Maitreya30Arnav/Mechnical_arm/Assem1.SLDASM

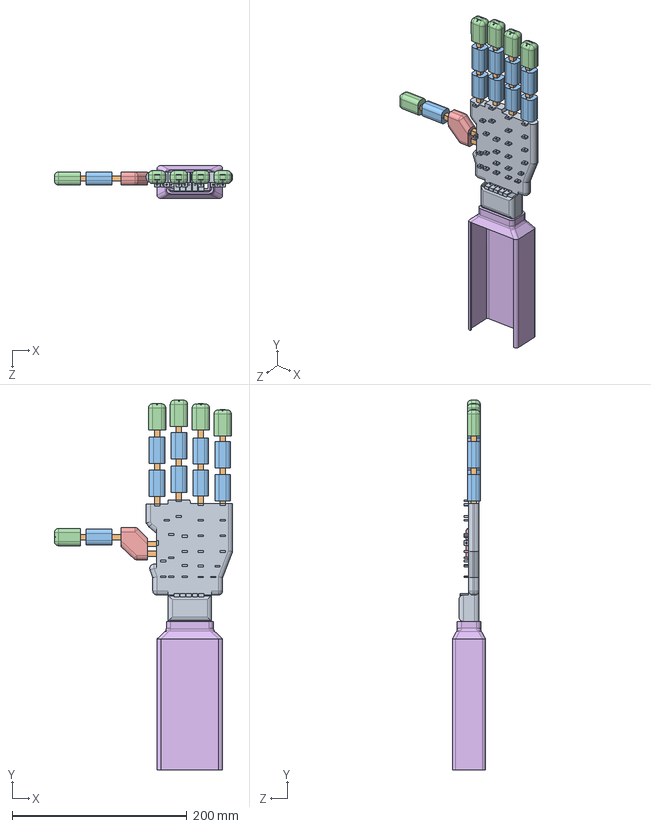
[picture p16: CAD file, 2024-07-07]
Assem1.SLDASM
204.1 x 423.2 x 38.0 mm
pp
MID FINGER PART x 9
finget tip x 5
th
hand extend
