Maitreya30Arnav/Mechnical_arm/Part3.SLDPRT

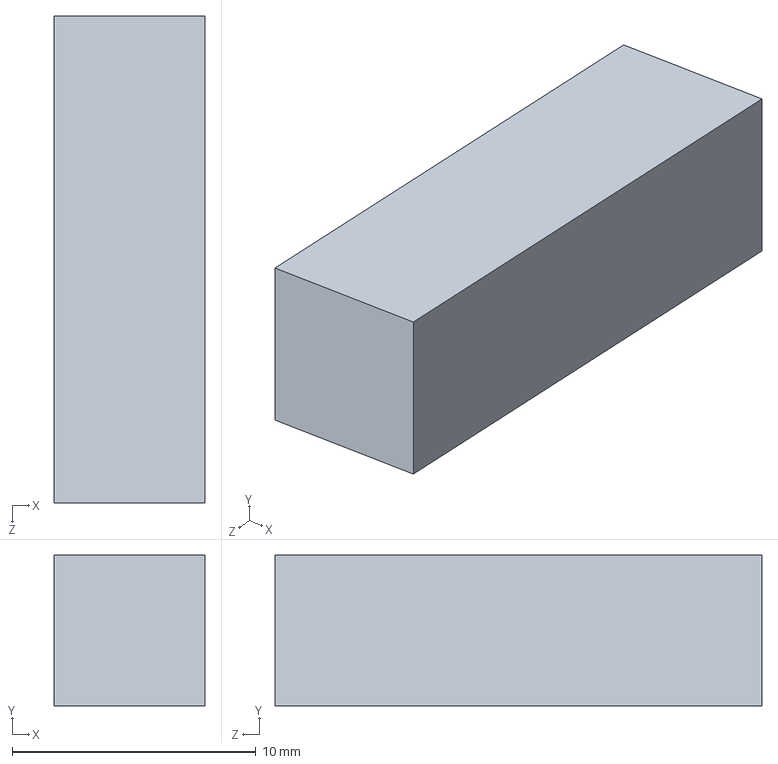
[picture p17: CAD file, 2024-07-07]
Part3.SLDPRT
6.20 x 6.20 x 20.0 mm
