Maitreya30Arnav/Mechnical_arm/finget tip.SLDPRT

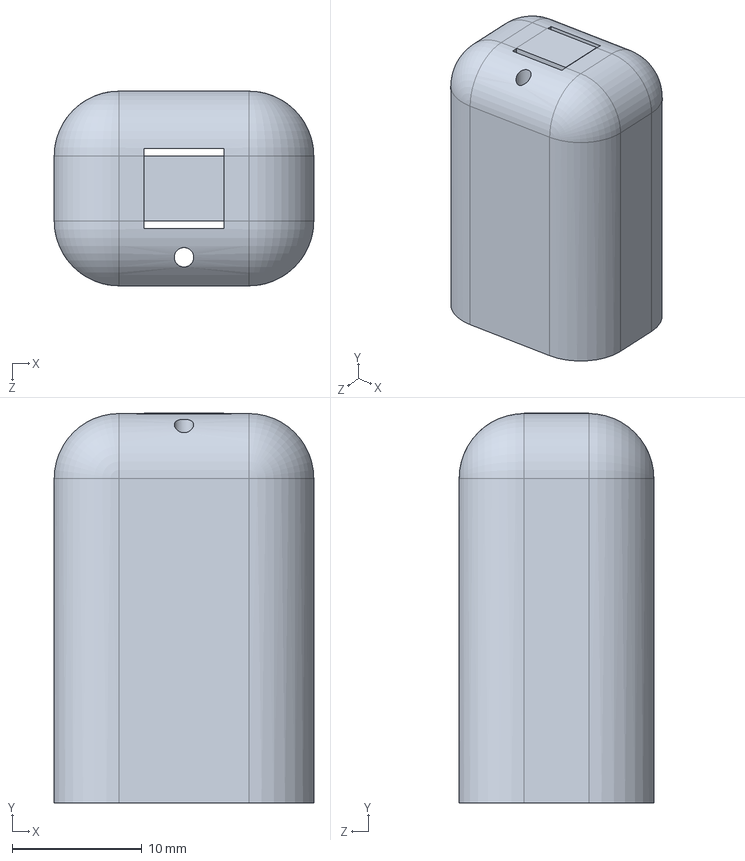
[picture p18: CAD file, 2024-07-07]
finget tip.SLDPRT
20.0 x 30.0 x 15.0 mm
