Maitreya30Arnav/Mechnical_arm/MID FINGER PART.SLDPRT

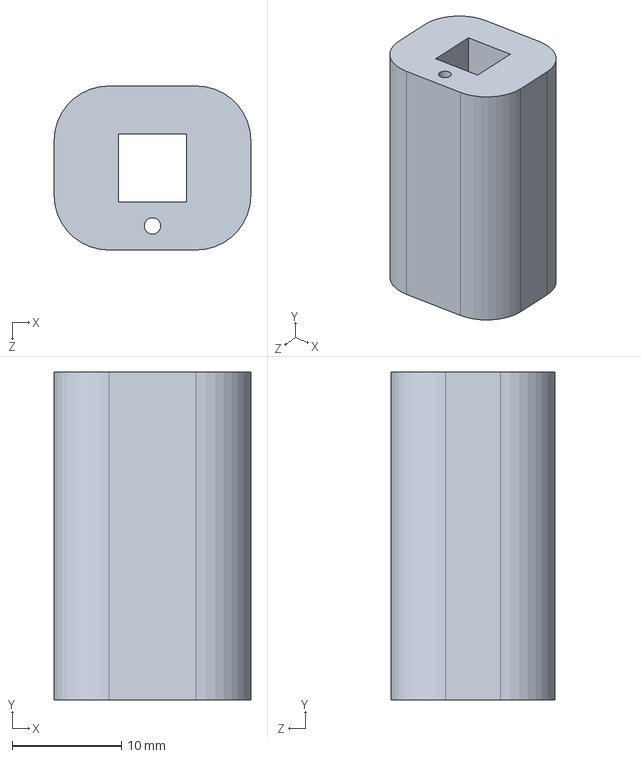
[picture p19: CAD file, 2024-07-07]
MID FINGER PART.SLDPRT
18.0 x 30.0 x 15.0 mm
