Maitreya30Arnav/Mechnical_arm/th.SLDPRT

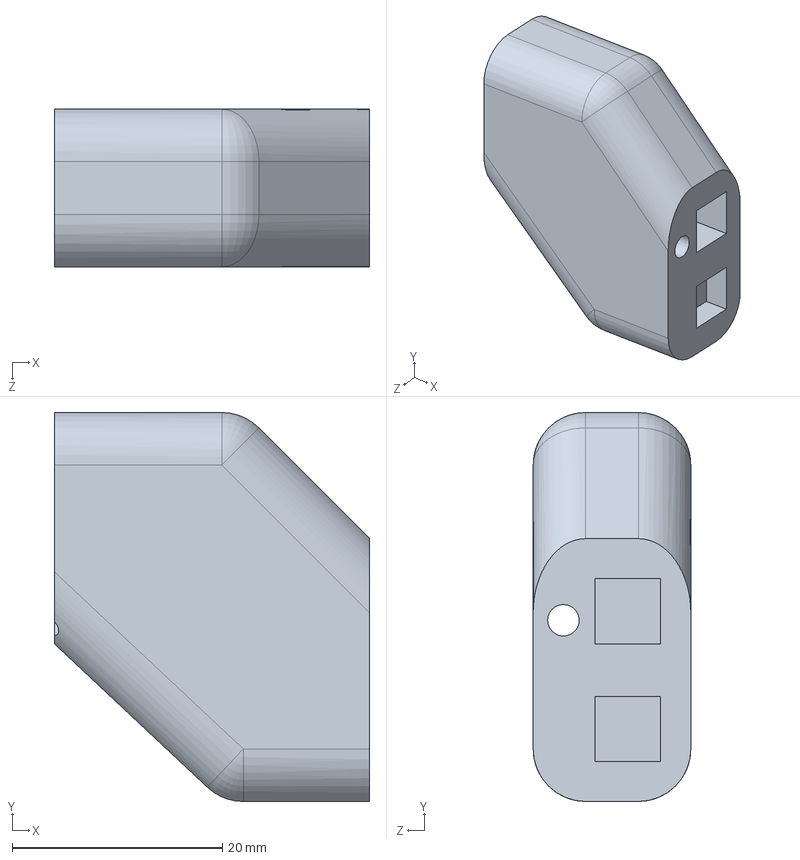
[picture p20: CAD file, 2024-07-07]
th.SLDPRT
30.0 x 37.0 x 15.0 mm
