Maitreya30Arnav/Mechnical_arm/pp.SLDPRT

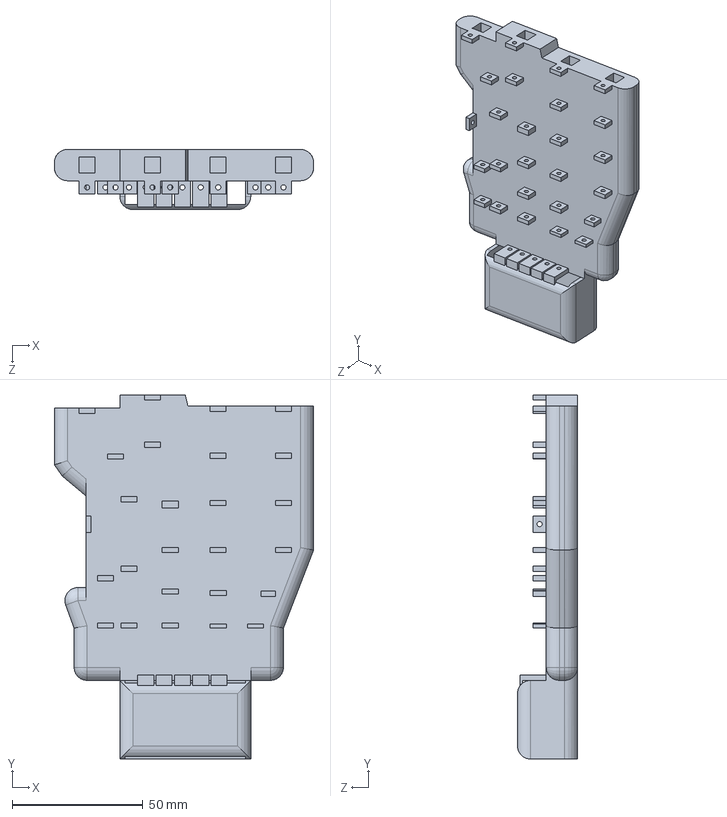
[picture p21: CAD file, 2024-07-07]
pp.SLDPRT
99.0 x 139.0 x 23.0 mm
