Maitreya30Arnav/Mechnical_arm/hand extend.SLDPRT

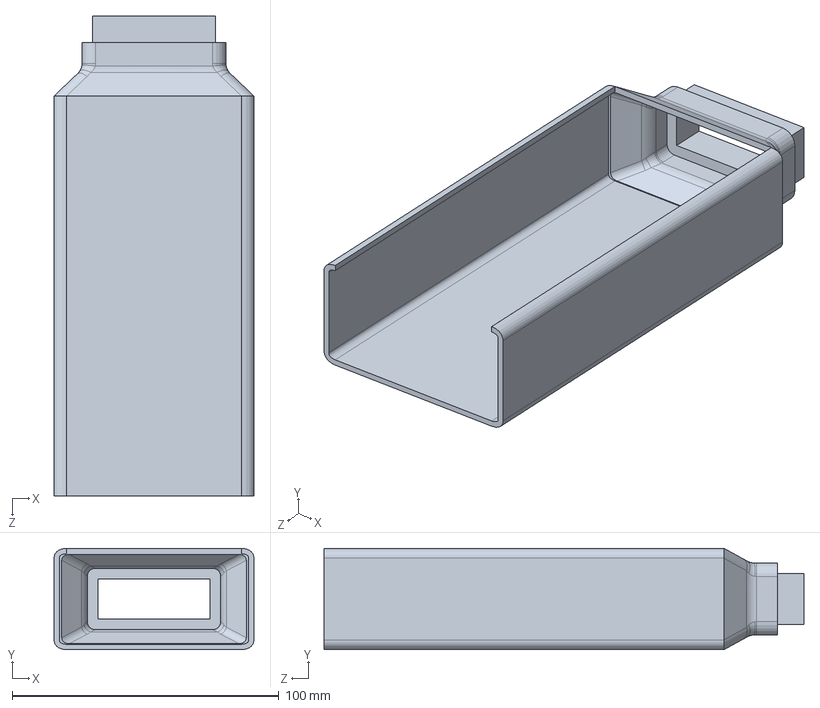
[picture p22: CAD file, 2024-07-07]
hand extend.SLDPRT
75.0 x 38.0 x 180.0 mm
